na2jpn/ESP32C3_APRS-igate/APRS_igate_esp32c3.png

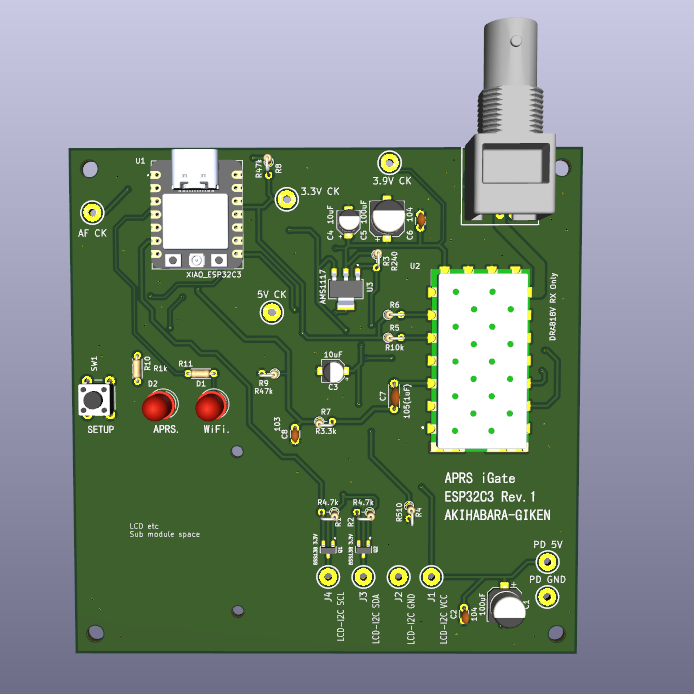
APRS_igate_esp32c3.png
