na2jpn/ESP32C3_APRS-igate/ESP32C3/APRS_iGate_C3_Rev1_2/README_JA.md

# APRS iGate ESP32C3 v1.2

XIAO ESP32C3 + DRA818V / 初期値144.660MHz / 1200bps Bell 202 AFSK受信専用。
秋葉原技研 / PS Ham-ware。2026-11-02。

## v1.2：8周波数プリセット・日英管理画面

管理画面の「受信周波数」で選択し、「保存して再起動」で保存します。
再起動後にDRA818V・Web・LCD・起動ログへ反映し、DRA初期化の再試行も保存値を使用します。

| MHz | 表示 / Region |
| --- | --- |
| 144.640 | — |
| 144.660 | JA・初期値 / default |
| 144.390 | US |
| 144.800 | EU |
| 145.175 | AU |
| 144.575 | NZ |
| 144.930 | AR |
| 145.570 | BR |

- 全周波数で1200bps AFSK。地域ラベルは代表例。日本の144.640MHzは一般に9600bps用ですが、本機に9600bps復調はありません。
- NVSの `rx_freq` に指定値を保存。未設定・不正な保存値は144.660MHz。v1.1の有効な保存値は維持します。
- Webから不正値は400で拒否。古い画面等から周波数項目を送らず保存した場合は選択を保持します。
- Wi-Fi・APRS-IS・自局ビーコン・OTAパスワードは引き継ぎます。RF/AFゲイン、DSP、ADC取得、PTT配線は変更しません。
- `/status` の `rf_mhz` と `afsk_baud` でも確認できます。

### 言語

各ページ上部の「日本語 / English」で切り替えます。設定・保存後/再起動待ち、音声モニター、受信記録、
ログ、OTAの案内・進捗・再試行メッセージを翻訳します。英語は `?lang=en`、日本語は `?lang=ja`。
言語指定なし・不明な指定は日本語です。通常の画面リンク・フォーム・60秒後の戻り先は選択言語を保持します。
言語は表示URLの指定で、NVSへの保存や再起動は不要です。英語を直接開く場合は `http://本機IP/?lang=en`。
未保存の入力は言語切り替えで失われます。OTA実行中は言語切り替えを抑止します。

ユーザーが入力したSSID・コメント・パケット本文は翻訳しません。生ログ、CSV列名、JSON/APIキー、
技術的な状態コードは従来の形式を保持します。時刻のJST表示は言語によって変更しません。

### 更新

初回USB：このフォルダーの `APRS_iGate_C3_Rev1_2.ino` を開き、全ヘッダー・生成済みUIを同じフォルダーに保持します。
既存v0.9以降のWeb OTA：`firmware/APRS_iGate_C3_v1.2_OTA.bin` を指定します。
更新後はRev1.2・RF・1200bps・APRS-IS VERIFIED・Samples増加・日英切り替えを確認してください。
詳細は同梱の初期設定PDFと[英語版概要](README_EN.md)、検証範囲は[TEST_NOTES.md](TEST_NOTES.md)。

以下は従来機能と修正経緯です。現在の周波数・言語設定は上記v1.2を優先してください。

## v1.0での修正経緯

旧版の144.640MHz / 1200bpsという組み合わせを、国内の一般的な1200bps運用に合わせて
144.660MHzへ修正しました。v1.0では固定でしたが、v1.1では上記の選択式になっています。
UART制御の9600bpsは無線側の通信速度とは別で、9600bps無線復調はありません。
PTTはハードウェアで受信状態に固定し、送信機能は追加していません。

### 実機で確認済みの範囲

2026-11-02、v0.12と試験用1200bps WAVを使い、ステータス3送信の正常復調、
さらに位置パケット1送信の正常復調・APRS-IS転送とaprs.fi位置表示をユーザーが確認しました。
表示経路はqAO,JH1HST-10。送受信周波数を合わせた試験であり、144.660MHzに変更した
v1.0の実機試験や、通常局の弱信号受信率・長時間安定性の確認を代替するものではありません。

## v0.12：音量計と本体での5秒ピーク保持

管理画面の「音声入力モニター / 波形・レベル」、または `http://本機IP/audio` を開きます。
認証は従来どおりadmin＋OTAパスワード（設定済みの場合）です。

- 緑バー：直近5個の40ms区間、約200msのAC RMS。測定平均からDC成分を除きます。
- 赤線：本体で連続集計した直近約5秒の最大40ms AC RMS。
  ブラウザーが取得しなかった区間も対象です。取得や別ブラウザーの閲覧で消費しません。
  高い値から約5秒経過すると、その時点で残っている区間の最大値まで下がります。
- 表示更新は約1秒間隔で、通信状況によって遅れます。
  集計自体は閲覧中のADCデータ全区間に対して行い、短い音をピークに残します。
  40ms未満の音は区間平均になるため、瞬間的なサンプル最大振幅そのものではありません。
- dBFSの基準は2048 ADCコード。%はその基準への線形比で、電波のS値・校正音圧ではありません。
- 波形は従来どおり最新40msの抜粋（264組の最小・最大）。音量計の200msとは別の測定窓です。
  波形40ms RMS、波形ピーク、ADC平均、Min/Max、端付近の数も別に表示します。
- 波形の固定倍率×1/×4/×16・自動倍率×1〜×32を継承します。
  倍率変更は波形だけに適用し、音量計の値を拡大しません。
- 一時停止は表示と値を保持します。要求停止から約3秒で本体のモニター計算が休止し、
  再開後は新しい履歴を作ります。APRS受信自体は表示停止で止まりません。
- 別タブで非表示、ページを閉じる、通信断による要求停止でも約3秒で休止。
  再試行待ちが3秒を超える場合も履歴はリセットされます。無人の常時記録ではありません。
- ADC読み取り失敗、データ欠落、復旧やOTAでは履歴を破棄します。
  無効な測定を音量ゼロとして表示せず、通信断でも古い値を消します。
- モニター固定RAMは3232B（v0.11から1048B増）。HTTP応答の一時ヒープは別です。
  追加のADC起動や新規タスクはありません。

### AMP追加を判断するための確認

FMでは無信号時の雑音が大きく、PTTを押すと音量計が下がる場合があります。
最初にPTTを押し無音で5秒程度待ち、待機雑音のピークが消えてから声や試験音を入れると、
入力された音のピークを比較しやすくなります。

同じ送信内容でデコードできた条件／できない条件を比較してください。
音量計・赤線・波形の振幅、上下限への張り付き、1200/2200Hz検出値、DMA欠落を併せて確認します。
音声経路が通ることだけでは、増幅不要・増幅必須のどちらも確定しません。
実電圧校正、RF感度、通常局のAPRS受信率、実機の追加CPU負荷は未検証です。
2026-11-02のv0.12実機試験では、1200bps試験WAVのRF受信・正常復調・APRS-IS転送・aprs.fi位置表示まで確認しました。

v0.11からの変更は音量計の集計・表示です。RFゲイン、DRA音量、復調しきい値、
ADC復旧処理、位置ビーコン、OTA、NTP、LCD/LEDは継承します。
Web OTAでは `firmware/APRS_iGate_C3_v1.1_OTA.bin` を指定してください。
更新後はRev1.1と接続状態を確認します。

## v0.10での変更と確認方法

v0.9実機ログで、Samplesが固定されたままTimeoutだけが増える状態を確認しました。
再起動後は実データが戻っています。停止を起こした根本原因は未確定です。
本版は受信停止の検知と復旧・記録を追加するもので、RF復調成功を保証するものではありません。

- 有効なADCデータが3秒来なければ、ADCタスク自身がstop→flush→startを実施します。
  3秒以上の間隔を空け最大3回。その後はFAULT表示を維持し、無限再試行や装置全体の自動再起動はしません。
  API成功後もRECOVERING表示を維持し、実データ受信後に復旧成功を記録します。
  有効データが継続する30秒間に読み取り失敗・欠落がなければ、試行回数の枠を戻します。
- 管理画面の「ADC取り込みを復旧」は同じ復旧処理を予約します。
  OTA中は409で拒否、ADC初期化失敗時は503で再起動が必要です。
  OTAパスワード設定時はadmin認証、未設定時も起動ごとのトークンを検証します。
- ADC表示：OK / STALE（データ鮮度1.5秒超・未受信など）/ RECOVERING /
  FAULT / PAUSED（OTA）/ INIT FAILED。初期化に成功しただけでOKにしません。
- モニターにTimeout、実取得サンプル数、最終取得からの時間、取得速度、復旧試行/成功数、
  意図的な破棄数を追加。本体ログは状態変化と10秒単位のoverflow/read error/timeout増分を記録します。
- 受信CSVの末尾に `adc_valid` 列を追加。1は実測、0は読み取り失敗です。
  `adc_valid=0` のRMS=0やMin/Max=2048は代用値であり、無音・実際のADC電圧を示しません。
- DMAプール8KB→16KB、ADCタスク優先度1→2。スタックは6144Bを維持し、
  最大4バッファ処理ごとに1tick休止します。欠落時は同期をリセットし最大32バッファを破棄します。
  DSPの毎サンプルの浮動小数点除算を同じ判定式の乗算比較へ変更しました。
  RFゲイン・AF音量・復調しきい値はv0.9から変更していません。
- 通常時のWi-Fi断は60秒継続してから設定APへ移行します。
  AP開始やWi-Fiスタック再初期化後はADC復旧を予約します。これが停止原因だと確定したわけではありません。
- v0.9のOTA再送・SHA256照合、位置ビーコン、NTP、LCD、LED、保存設定を継承します。

導入済みv0.9からは通常のWeb OTAで同梱のv0.10アプリbinを送信してください。
再接続後にRev0.10、APRS-IS VERIFIED、Samples/Captureの増加、Timeout・overflowの推移を確認します。
停止が再発した場合は、本体ログと受信CSVを再起動前に保存してください。
RAMログは電源断・再起動で消えます。長期間の無人保持はできません。

## 初回導入の注意

**自動再試行・途中再開が使えるのは、本体にv0.9を導入した後です。**
更新先binだけで動作中のv0.7/0.8のアップローダーは変えられません。
初回は通信が安定する環境、またはUSBで本版を書き込んでください。
旧版の送信が途中で切れた場合、電源を維持し、本体ログを保存して120秒の
セッション解除後に更新ページを開き直します。旧版の途中データは再開できません。

Web更新ファイル：`firmware/APRS_iGate_C3_v1.1_OTA.bin`（アプリ単体）。
ZIP/merged/bootloader/partitionsは送信しません。認証はadminとOTAパスワード。
設定は継承します。更新後はRev1.1・稼働時間・接続状態を確認してください。
v0.9でRTC記録形式を拡張したため、旧版から初回導入した直後のPREVIOUS OTAが
表示されない場合があります。v0.9以降同士の試験では記録の照合も使えます。

USB：`APRS_iGate_C3_Rev1_1.ino`と全ヘッダーを同じフォルダーへ。
Arduino IDE 2.3.10 / Core 3.3.12 / XIAO_ESP32C3 / Flash 4MB /
USB CDC On Boot Enabled / Default 4MB with spiffs (1.2MB APP/1.5MB SPIFFS)。
通常は全フラッシュ消去を無効にします。

## v0.9以降でのWeb更新

1. 管理画面のOTAリンクを開き直し、アプリ単体binを選択。
2. 「更新開始・再開」でSHA-256を計算し、1KBずつ送信します。
3. 通信断時は1/2/4/8/15秒（上限15秒）の間隔で受信位置を照合し、未受信分から継続。
4. 全量受信・SHA-256照合・イメージ検証後、2秒後に再起動。
5. 約30秒後から再接続を確認。版番号・稼働時間・本体ログ・VERIFIEDを確認。

- 1リクエストは30秒で打ち切り。操作ごとの復帰待ちは進捗なしで最大約8分。
- 更新全体に5分/8分の制限はありません。受信確認が続く限り継続します。
- 本体は最後の新規データ受信から10分で解除。状態照会や同一ブロック再送だけでは延長しません。
- 更新中もWi-Fi自動再接続と15秒間隔の再接続要求を行います。
  通常経路のAPRS再接続・AP移行・Wi-FiモードOFF/ON・長時間障害の強制再起動はOTA中に行いません。
- 受信・転送は更新中休止します。完全な無通信が続く場合は最長10分休止します。
- 中止ボタンも本体の応答を確認してから中止と表示します。届かない場合はタイムアウトで解除。
- 検証確定後の中止はできません。検証結果の照合中は結果確認を優先します。

### ページを閉じた・開き直した場合

本体の電源とセッションが維持されていれば、**同じブラウザー・同じURL（同じorigin）で
同じbinを選び、「更新開始・再開」**を押すと続行できます。
ファイル名ではなく全体SHA-256、サイズ、起動トークン、クライアントキー、セッションIDを照合します。
ブラウザーにはキー等のメタデータだけを保存し、ファイル本体・認証パスワードは保存しません。
localStorageが禁止されている場合、同じページ内の復帰はできますが、再読込後のキー保持はできません。
別ブラウザー・別URL・別ファイルへの自動引き継ぎはしません。10分経過で解除された後は最初から送ります。

### 応答が失われた場合の保険

- 開始要求は同じキー・SHA・サイズなら同じセッションを返し、Flashを再初期化しません。
- 書き込み済み位置を確認してから次へ進みます。
- 直前と同じオフセット・長さ・SHA-256のブロック再送はACKだけ返し、二重書き込みしません。
- 受信全体のSHA-256も本体で計算し、申告されたファイルのSHAと一致しなければ検証・起動切替をしません。
- 本体の起動トークンが変わった場合、送信途中のセッションは再開しません。
- 検証応答だけ失われて既に再起動した場合、対応ファームのRTC記録に同じSHA・キー・サイズの
  検証成功が残っていれば照合できます。対象ファームが新形式に非対応、電源断、RTC消失なら成功とは断定しません。

本体のIPが変わった場合、ブラウザーが別アドレスへ自動追従する機能はありません。
給電・Wi-Fi環境・ブラウザーのスリープ等、通信断そのものを防ぐ保証ではありません。
新アプリが起動不能になったときの自動ロールバックは未実装で、USB復旧が必要です。
SHA-256はファイル同一性と整合性の確認であり、署名による配布元認証ではありません。

## v0.8から継承

受信変化の診断記録、NTP/JST、約1dB分の弱入力しきい値調整をそのまま継承しています。
今回、RF・復調感度の追加変更はありません。

## まず診断記録を取る

1. 管理画面の **受信変化の記録 / RX diagnostics**（`/rxdiag`）を開く。
2. 必要なら「記録消去・再開」。約1秒、普段の音声レベルを学習させる。
3. 既知のAPRSパケットを送信する。
4. 送信後、速やかに「記録停止」→「CSVダウンロード」。録画は不要。
5. 自動記録が出ない場合は「記録再開」→「手動記録」を押してすぐ送信する。

音声のRMS上下変化、トーン合計・比率変化、ADC端付近、CRC・正常フレーム・
フレーム異常・DMA overflow・読み取り異常のカウンター変化をADCタスクで監視します。
雑音も記録対象です。記録があること自体はAPRS受信成功を意味しません。

- 約20ms（528サンプル）ごと。直前最大8行（160ms）＋開始点以後、合計最大48行（約960ms）。
- 最大4イベント。古いイベントから上書き。再起動・電源断で消えるRAM記録。
- 通常時、イベント終了後500msの再トリガー待機あり。正常フレーム・手動開始は待機を迂回。
- 1イベントの全期間を必ず収録する録音機能ではありません。raw音声は保存しません。
- RMSは復調器の平滑電力の区間平均から算出。1200/2200Hz値は各20ms区間末尾の検出値。
- ADC Min/Maxは区間全体。カウンターは累計と行間差分。最初の行の差分は0。
- ADC読み取り失敗の行はサンプル数不変、Min/Max=2048の便宜値。波形として解釈しません。
- イベントのreasonは期間中の理由のビット合計。trigger=1は開始行。complete=0は途中の記録。
- OTA中は記録を休止し、CSV取得・記録操作を拒否。完了後に確認してください。
- 雑音の変化が続くと4件が短時間で入れ替わるため、試験後は速やかに記録停止して保存。
- 本体イベントログ（4KB、`/logs`）とは別枠。どちらもOTAパスワード設定時はadmin認証。

初期しきい値：RMSは基準比30%かつ絶対差0.012以上、トーン合計は35%かつ0.006以上、
トーン比は0.45以上（合計0.008超）。比較は厳密には「超えた場合」。
ADC端付近は0〜16または4079〜4095。
平常値は約1秒の初期学習後、イベント外で追従します。
これは初期試験値です。取り逃し・雑音反応を実機CSVで評価します。

## NTP日時

Wi-Fi接続後、NICT / Cloudflare / pool.ntp.orgへ非同期で時刻合わせします。
受信開始を時刻同期待ちで止めません。JST表示です。

- 同期前はUNSYNCと起動からの経過msのみ。
- 同期後はJST日時（ミリ秒表示）と64bitの経過msを両方保存。
- 同期前の記録を後から同期済み日時へ書き換えません。
- 時計補正が起きても既存の記録日時は維持。順序・間隔の確認は経過msを使います。
- 管理画面のClockには最終同期からの経過秒も表示。通信断後は同期時点からの推定時計です。
- 記録日時はADCデータを処理した時点です。DMAバッファ遅延を含み、RF到来時刻の精密測定ではありません。
- ミリ秒表示は時刻精度を保証する意味ではありません。NTP実通信は実機確認が必要です。

## 小幅な復調しきい値変更

`config.h`の2定数のみ調整しました（RFゲイン、DRA音量・フィルター、ADC設定は変更なし）。

| 判定 | v0.7 | v0.8 |
| --- | ---: | ---: |
| AFSK_MIN_MEAN_SQUARE | 1.0e-5 | 8.0e-6 |
| AFSK_MIN_TONE_POWER | 2.0e-6 | 1.6e-6 |

電力しきい値20%低下、振幅しきい値約10.6%低下（約0.97dB）。
トーン判定のヒステリシス・ビット同期・HDLC/FCS/AX.25/APRS転送は維持します。
偽のCRC試行が増える可能性はありますが、CRC検証は緩めません。
**前回のRMS約0.13は旧しきい値を十分超えており、この調整だけで解決するとは主張しません。**
戻す場合は2定数をv0.7値へ戻してコンパイルするか、保管したv0.7アプリbinをOTAします。

## 継承機能・資料

位置ビーコンは有効時に認証後初回と以後30分。Gridは保存のみ。Commentは40バイト以内。
LCDは15分ごとに3画面×4秒×2周（約24秒）。短押し60秒。
正常LEDは30秒周期：0〜10秒Wi-Fi、10〜20秒APRS、20〜30秒両方消灯。
SETUPは離した時に判定：短押しLCD、5〜15秒未満AP、15秒以上全設定消去。
AP：APRS-iGate-XXXX / aprssetup / http://192.168.4.1/。
通常：http://aprs-igate.local/ または本機IP。設定保存後は60秒でトップに遷移します。

最新版の初期設定ガイドはZIP直下の `Initial_Setup_Guide_PDF/APRS_iGate_C3_v1_1_Initial_Setup_Guide_JA.pdf` を参照してください。
旧版PDFの144.640MHz表記は本版には適用しません。
v1.1の設定・機能と更新手順は本READMEを優先してください。旧版からの導入については本README冒頭の注意を参照してください。
検証詳細はTEST_NOTES.md。通常局の受信率・長時間安定性・追加診断のCPU負荷・NTP同期は継続確認事項です。
