na2jpn/ESP32C3_APRS-igate/diagram.pdf

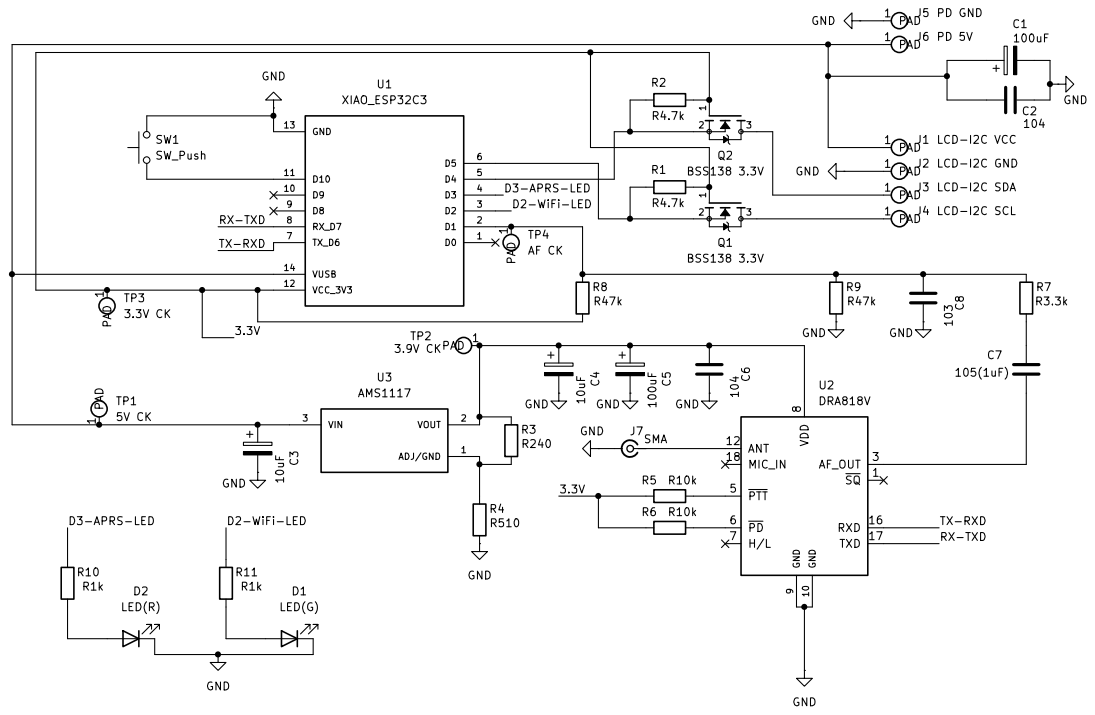
[picture p2: page 1]
