na2jpn/ESP32C3_APRS-igate/ESP32C3/APRS_iGate_C3_Rev1_2/settings.h

#pragma once

#include <Arduino.h>
#include <Preferences.h>
#include "config.h"

struct AppConfig {
  String rxFrequency = DEFAULT_DRA_RX_FREQ;
  String wifiSsid;
  String wifiPass;
  String callsign;
  String aprsPasscode;
  String aprsServer = DEFAULT_APRS_SERVER;
  uint16_t aprsPort = DEFAULT_APRS_PORT;
  String grid;
  bool beaconEnabled = false;
  String latitude;
  String longitude;
  String otaPassword;
  String comment = "RX-only APRS iGate";
};

class SettingsStore {
public:
  bool load(AppConfig &cfg) {
    Preferences p;
    if (!p.begin("igate", true)) return false;
    cfg.rxFrequency  = p.getString("rx_freq", DEFAULT_DRA_RX_FREQ);
    cfg.wifiSsid     = p.getString("ssid", "");
    cfg.wifiPass     = p.getString("wpass", "");
    cfg.callsign     = p.getString("call", "");
    cfg.aprsPasscode = p.getString("apass", "");
    cfg.aprsServer   = p.getString("server", DEFAULT_APRS_SERVER);
    cfg.aprsPort     = p.getUShort("port", DEFAULT_APRS_PORT);
    cfg.grid         = p.getString("grid", "");
    cfg.comment      = p.getString("comment", "RX-only APRS iGate");
    cfg.beaconEnabled = p.getBool("beacon", false);
    cfg.latitude = p.getString("lat", "");
    cfg.longitude = p.getString("lon", "");
    cfg.otaPassword = p.getString("otapass", "");
    p.end();
    normalize(cfg);
    return true;
  }

  bool save(AppConfig cfg) {
    normalize(cfg);
    Preferences p;
    if (!p.begin("igate", false)) return false;
    p.putString("rx_freq", cfg.rxFrequency);
    p.putString("ssid", cfg.wifiSsid);
    p.putString("wpass", cfg.wifiPass);
    p.putString("call", cfg.callsign);
    p.putString("apass", cfg.aprsPasscode);
    p.putString("server", cfg.aprsServer);
    p.putUShort("port", cfg.aprsPort);
    p.putString("grid", cfg.grid);
    p.putBool("beacon", cfg.beaconEnabled);
    p.putString("lat", cfg.latitude);
    p.putString("lon", cfg.longitude);
    p.putString("otapass", cfg.otaPassword);
    p.putString("comment", cfg.comment);
    p.end();
    return true;
  }

  void clear() {
    Preferences p;
    if (p.begin("igate", false)) {
      p.clear();
      p.end();
    }
  }

  static bool validRxFrequency(const String &frequency) {
    for (const auto &channel : RF_CHANNELS) {
      if (frequency == channel.frequency) return true;
    }
    return false;
  }

  static String rxFrequencyLabel(const AppConfig &cfg) {
    return cfg.rxFrequency.substring(0, 7);
  }

  static bool validForStation(const AppConfig &cfg) {
    return cfg.wifiSsid.length() > 0 && validCallsign(cfg.callsign);
  }

  static bool validCallsign(String s) {
    s.trim();
    s.toUpperCase();
    if (s.length() < 3 || s.length() > 9) return false;
    int hyphen = s.indexOf('-');
    String base = hyphen >= 0 ? s.substring(0, hyphen) : s;
    String ssid = hyphen >= 0 ? s.substring(hyphen + 1) : "";
    if (base.length() < 3 || base.length() > 6) return false;
    for (size_t i = 0; i < base.length(); ++i) {
      if (!isAlphaNumeric(base[i])) return false;
    }
    if (hyphen >= 0) {
      if (ssid.length() < 1 || ssid.length() > 2) return false;
      for (size_t i = 0; i < ssid.length(); ++i) {
        if (!isAlphaNumeric(ssid[i])) return false;
      }
      if (ssid == "0") return false;
    }
    return true;
  }

  static void normalize(AppConfig &cfg) {
    cfg.rxFrequency.trim();
    if (!validRxFrequency(cfg.rxFrequency)) cfg.rxFrequency = DEFAULT_DRA_RX_FREQ;
    cfg.wifiSsid.trim();
    cfg.callsign.trim();
    cfg.callsign.toUpperCase();
    cfg.aprsPasscode.trim();
    cfg.aprsServer.trim();
    cfg.latitude.trim();
    cfg.longitude.trim();
    cfg.grid.trim();
    cfg.grid.toUpperCase();
    cfg.comment.trim();
    if (cfg.aprsServer.length() == 0) cfg.aprsServer = DEFAULT_APRS_SERVER;
    if (cfg.aprsPort == 0) cfg.aprsPort = DEFAULT_APRS_PORT;
    if (cfg.comment.length() > 40) cfg.comment = cfg.comment.substring(0, 40);
  }
};
