na2jpn/ESP32C3_APRS-igate/ESP32C3/APRS_iGate_C3_Rev1_2/ui_texts.h

#pragma once
#include <cstring>
struct UiText { const char *key; const char *marker; const char *ja; const char *en; };
static const UiText UI_TEXTS[] = {
  {"rf.title", "{{rf.title}}", "受信周波数", "Receive frequency"},
  {"rf.default", "{{rf.default}}", "初期値", "default"},
  {"rf.note", "{{rf.note}}", "全周波数で1200bps AFSKです。日本の一般的な1200bps運用は144.660MHz、144.640MHzは一般に9600bps用です。本機は9600bpsの復調には対応していません。地域表示は代表例です。変更は保存・再起動後に反映します。", "All presets use 1200bps AFSK. In Japan, 144.660MHz normally uses 1200bps and 144.640MHz normally uses 9600bps. This device does not decode 9600bps. Region labels are examples. Save and reboot to apply changes."},
  {"field.ssid", "{{field.ssid}}", "Wi-Fi SSID", "Wi-Fi SSID"},
  {"field.wpass", "{{field.wpass}}", "Wi-Fiパスワード", "Wi-Fi password"},
  {"field.call", "{{field.call}}", "iGateコールサイン・SSID", "iGate callsign-SSID"},
  {"field.apass", "{{field.apass}}", "APRS-ISパスコード", "APRS-IS passcode"},
  {"field.server", "{{field.server}}", "APRS-ISサーバー", "APRS-IS server"},
  {"field.port", "{{field.port}}", "ポート", "Port"},
  {"field.grid", "{{field.grid}}", "グリッド（保存のみ）", "Grid (stored only)"},
  {"field.comment", "{{field.comment}}", "コメント", "Comment"},
  {"field.lat", "{{field.lat}}", "緯度（十進度・南緯は負）", "Latitude (decimal degrees, south negative)"},
  {"field.lon", "{{field.lon}}", "経度（十進度・西経は負）", "Longitude (decimal degrees, west negative)"},
  {"field.otapass", "{{field.otapass}}", "OTAパスワード（8～63文字・空欄で保持）", "OTA password (8-63 characters; blank keeps current)"},
  {"main.ip", "{{main.ip}}", "IP:", "IP:"},
  {"main.uptime", "{{main.uptime}}", "稼働時間:", "Uptime:"},
  {"main.decoded", "{{main.decoded}}", "復調:", "Decoded:"},
  {"main.gated", "{{main.gated}}", "転送:", "Gated:"},
  {"main.dup", "{{main.dup}}", "重複:", "Duplicates:"},
  {"main.blocked", "{{main.blocked}}", "除外:", "Blocked:"},
  {"main.crc", "{{main.crc}}", "CRC不一致:", "CRC bad:"},
  {"main.rms", "{{main.rms}}", "AF RMS:", "AF RMS:"},
  {"main.last", "{{main.last}}", "最終受信:", "Last RX:"},
  {"main.clock", "{{main.clock}}", "時刻:", "Clock:"},
  {"main.beacons", "{{main.beacons}}", "自局ビーコンTCP送出:", "Position beacon TCP writes:"},
  {"field.keep", "{{field.keep}}", "空欄で保存済み値を保持", "Blank keeps current"},
  {"main.monitor", "{{main.monitor}}", "AFSK受信モニター（1秒更新）", "AFSK receive monitor (updates every second)"},
  {"main.loading", "{{main.loading}}", "モニター取得中...", "Loading monitor..."},
  {"main.hint", "{{main.hint}}", "ADC最小・最大は直近250msの生コードです。1200/2200Hz値は検出強度で、校正済みdBではありません。ピークは約5秒保持します。", "ADC Min/Max are raw codes over the last 250ms. Tone values are detector magnitudes, not calibrated dB. RMS peak is held for about 5 seconds."},
  {"field.beacon", "{{field.beacon}}", "自局位置をAPRS-ISへ送る（30分間隔）", "Send own position to APRS-IS (every 30 minutes)"},
  {"button.save", "{{button.save}}", "保存・再起動", "Save &amp; Reboot"},
  {"link.rx", "{{link.rx}}", "受信変化の記録", "RX diagnostics"},
  {"link.audio", "{{link.audio}}", "音声入力モニター / 波形・レベル", "Audio input monitor / waveform and level"},
  {"link.logs", "{{link.logs}}", "本体ログ", "Device log"},
  {"link.ota", "{{link.ota}}", "ファームウェア更新（OTA）", "Firmware update (OTA)"},
  {"main.admin", "{{main.admin}}", "ユーザー名: admin", "User: admin"},
  {"button.adc", "{{button.adc}}", "ADC取り込みを復旧", "Recover ADC capture"},
  {"main.maintenance", "{{main.maintenance}}", "保守操作", "Maintenance"},
  {"confirm.factory", "{{confirm.factory}}", "保存設定をすべて消去しますか？", "Erase all saved settings?"},
  {"button.reboot", "{{button.reboot}}", "再起動", "Reboot"},
  {"button.factory", "{{button.factory}}", "設定を初期化", "Factory reset"},
  {"main.buttonhint", "{{main.buttonhint}}", "SETUPボタン: 短押しでLCDを60秒点灯 / 15分ごとに24秒自動点灯 / 5秒で設定AP / 15秒で全設定消去。設定APパスワード:", "SETUP: short press lights LCD for 60s / automatic 24s every 15 minutes / 5s opens setup AP / 15s erases all settings. Setup AP password:"},
  {"reboot.title", "{{reboot.title}}", "再起動中です", "Rebooting"},
  {"reboot.wait", "{{reboot.wait}}", "60秒後にトップ画面へ自動で戻ります。", "Returning to the main page automatically in 60 seconds."},
  {"reboot.home", "{{reboot.home}}", "トップ画面を開く", "Open the main page"},
  {"reboot.ip", "{{reboot.ip}}", "本機のIPアドレスが変わった場合は、新しいアドレスで開いてください。", "If the device IP address changed, open its new address."},
  {"live.unavailable", "{{live.unavailable}}", "モニター取得失敗: ", "Monitor unavailable: "},
  {"live.decoded", "{{live.decoded}}", " | 復調: ", " | Decoded: "},
  {"live.samples", "{{live.samples}}", " | サンプル: ", " | Samples: "},
  {"live.errors", "{{live.errors}}", " | 読取エラー: ", " | Read errors: "},
  {"live.timeout", "{{live.timeout}}", " | タイムアウト: ", " | Timeouts: "},
  {"live.age", "{{live.age}}", " | データ経過: ", " | Data age: "},
  {"live.rate", "{{live.rate}}", " | 取得速度: ", " | Capture rate: "},
  {"live.recovery", "{{live.recovery}}", " | 復旧試行/成功: ", " | Recovery attempts/success: "},
  {"live.discarded", "{{live.discarded}}", " | 破棄: ", " | Discarded: "},
  {"live.stack", "{{live.stack}}", " | スタック空き: ", " | Stack free: "},
  {"live.block", "{{live.block}}", " | 最大処理区間: ", " | Max block: "},
  {"error.rf", "{{error.rf}}", "受信周波数を一覧から選択してください。", "Select a receive frequency from the preset list."},
  {"error.password", "{{error.password}}", "OTAパスワードは8～63文字で指定してください。", "OTA password must be 8-63 characters."},
  {"error.position", "{{error.position}}", "位置ビーコンには有効な緯度・経度が必要です。", "Valid latitude and longitude are required for the position beacon."},
  {"error.config", "{{error.config}}", "SSIDまたはコールサインが不正です。", "SSID or callsign is invalid."},
  {"error.save", "{{error.save}}", "設定を保存できませんでした。", "Failed to save settings."},
  {"saved", "{{saved}}", "設定を保存しました。再起動します。", "Settings saved. Rebooting..."},
  {"erased", "{{erased}}", "設定を消去しました。再起動します。", "Settings erased. Rebooting..."},
  {"restarting", "{{restarting}}", "再起動します。", "Rebooting..."},
  {"error.busy", "{{error.busy}}", "OTA更新中です。完了または中止を待ってください。", "OTA in progress. Finish or cancel it first."},
  {"adc.requested", "{{adc.requested}}", "ADC復旧を予約しました。管理画面でサンプル増加と本体ログを確認してください。", "ADC recovery requested. Check sample progress and device logs on the main page."},
  {"error.adc", "{{error.adc}}", "ADC未初期化です。本体を再起動してください。", "ADC is not initialized. Reboot required."},
  {"logs.title", "{{logs.title}}", "本体ログ", "Device log"},
  {"logs.hint", "{{logs.hint}}", "最大4KB / 古い行から上書き / NTP同期後はJST日時と経過時間、同期前はUNSYNC表示。RAMログは再起動・電源断で消えます。", "Up to 4KB; oldest lines are overwritten. After NTP sync, timestamps use JST and uptime; otherwise UNSYNC. RAM logs are lost on reboot or power loss."},
  {"logs.refresh", "{{logs.refresh}}", "更新", "Refresh"},
  {"logs.download", "{{logs.download}}", "ダウンロード", "Download"},
  {"logs.clear", "{{logs.clear}}", "ログ消去", "Clear log"},
  {"logs.back", "{{logs.back}}", "管理画面へ戻る", "Back to main page"},
  {"logs.loading", "{{logs.loading}}", "読み込み中...", "Loading..."},
  {"logs.failure", "{{logs.failure}}", "ログ取得失敗: ", "Log fetch failed: "},
  {"logs.confirm", "{{logs.confirm}}", "ログを消去しますか？", "Clear the log?"},
  {"logs.clearfail", "{{logs.clearfail}}", "消去失敗: ", "Clear failed: "},
  {"rx.title", "{{rx.title}}", "受信変化の記録", "RX diagnostics"},
  {"rx.hint", "{{rx.hint}}", "音声・トーン・ADC・復調カウンターの怪しい変化を記録します。APRS受信の確定判定ではありません。最大4件、古いイベントから上書き。再起動・電源断で消えます。", "Records changes in audio, tones, ADC and decoder counters. Events do not prove an APRS reception. Up to 4 events; oldest overwritten. Lost on reboot or power loss."},
  {"rx.window", "{{rx.window}}", "約20msごと / 直前最大8行＋変化後、合計最大48行（約0.96秒）。トーンは各区間末尾の値、RMSは平滑電力の区間平均です。通信処理の遅れに左右されずADCタスクで記録します。", "About 20ms per row; up to 8 pre-trigger rows and 48 rows total (about 0.96s). Tones are end-of-window detector values; RMS averages smoothed power. Captured in the ADC task independently of HTTP timing."},
  {"rx.holdhint", "{{rx.holdhint}}", "送信後は「記録停止」で保持してからダウンロードしてください。待機時の雑音でも反応するため、記録が流れる場合があります。「手動記録」は次の区間から記録を開始します。", "After transmitting, freeze the records before downloading. Idle noise may trigger and overwrite events. Manual capture starts at the next interval."},
  {"rx.freeze", "{{rx.freeze}}", "記録停止", "Freeze records"},
  {"rx.resume", "{{rx.resume}}", "記録再開", "Resume recording"},
  {"rx.manual", "{{rx.manual}}", "手動記録", "Manual capture"},
  {"rx.clear", "{{rx.clear}}", "記録消去・再開", "Clear and resume"},
  {"rx.refresh", "{{rx.refresh}}", "表示更新", "Refresh"},
  {"rx.csv", "{{rx.csv}}", "CSVダウンロード", "Download CSV"},
  {"rx.log", "{{rx.log}}", "本体ログ", "Device log"},
  {"rx.back", "{{rx.back}}", "管理画面へ戻る", "Back to main page"},
  {"rx.loading", "{{rx.loading}}", "読み込み中...", "Loading..."},
  {"rx.reason", "{{rx.reason}}", "reason（ビット合計）: 1=RMS上下変化、2=トーン合計変化、4=トーン比変化、8=ADC端付近、16=CRC増加、32=正常フレーム、64=フレーム/DMA/読取異常、128=手動。trigger=1の行が開始点。adc_valid=0は有効なADCデータがない行です。差分カウンターは前の記録区間からの増分です。", "reason bit mask: 1=RMS change, 2=tone sum, 4=tone balance, 8=ADC edge, 16=CRC increase, 32=valid frame, 64=frame/DMA/read fault, 128=manual. trigger=1 marks the trigger row. adc_valid=0 means no valid ADC measurement. Delta counters are changes since the preceding interval."},
  {"rx.fetchfail", "{{rx.fetchfail}}", "取得失敗: ", "Fetch failed: "},
  {"rx.confirm", "{{rx.confirm}}", "診断記録を消去して再開しますか？", "Clear diagnostic records and resume?"},
  {"rx.opfail", "{{rx.opfail}}", "操作失敗: ", "Operation failed: "},
  {"scope.title", "{{scope.title}}", "音声入力モニター", "Audio input monitor"},
  {"scope.main", "{{scope.main}}", "管理画面", "Main page"},
  {"scope.rx", "{{scope.rx}}", "受信変化の記録", "RX diagnostics"},
  {"scope.logs", "{{scope.logs}}", "本体ログ", "Device log"},
  {"scope.intro", "{{scope.intro}}", "同じ周波数のFMで「あー → 無音 → あー」と数秒ずつ区切り、声に同期する変化を確認します。<b>電波のSメーターではなく、ESP32のADCに届いた音声の強さです。</b> FMは無信号時の雑音のほうが大きく、受信するとレベルが下がる場合もあります。", "Transmit voice, silence, then voice on the same FM frequency and watch for matching changes. <b>This is audio reaching the ESP32 ADC, not RF signal strength.</b> Idle FM noise may be louder than received audio."},
  {"scope.freeze", "{{scope.freeze}}", "一時停止・保持", "Pause and hold"},
  {"scope.gain", "{{scope.gain}}", "表示倍率", "Display gain"},
  {"scope.fixed", "{{scope.fixed}}", "固定", "Fixed"},
  {"scope.auto", "{{scope.auto}}", "自動拡大（DC除去）", "Auto scale (DC removed)"},
  {"scope.waiting", "{{scope.waiting}}", "取得待ち...", "Waiting for capture..."},
  {"scope.meterlabel", "{{scope.meterlabel}}", "音声入力 AC RMS dBFS", "Audio input AC RMS dBFS"},
  {"scope.meterhint", "{{scope.meterhint}}", "緑：直近200msのAC RMS ／ 赤線：本体で連続集計した直近約5秒の最大40ms AC RMS。2048 ADCコードを0 dBFSの基準とします。停止中は保持します。", "Green: latest 200ms AC RMS. Red: maximum 40ms AC RMS over about 5 seconds, accumulated on the device. 2048 ADC codes is the 0 dBFS reference. Pausing holds the display."},
  {"scope.await", "{{scope.await}}", "有効な測定を待っています。", "Waiting for valid measurements."},
  {"scope.canvas", "{{scope.canvas}}", "ADC入力波形", "ADC input waveform"},
  {"scope.range", "{{scope.range}}", "表示範囲：ADC 0〜4095 ／ ×1 ／ 中心2048", "Range: ADC 0-4095 / x1 / center 2048"},
  {"scope.wavehint", "{{scope.wavehint}}", "1枚約40ms、4サンプルごとの最小・最大を縦線表示。横軸は0〜40ms、縦軸はADCコードです。自動拡大では倍率・中心を明示します。入力端付近は赤色で警告します。ADCコードから電圧への校正は行っていません。", "Each frame covers about 40ms. Vertical lines show min/max for each group of four samples. X: milliseconds; Y: ADC codes. Auto scale shows gain and center. Near-edge input is red. ADC codes are not voltage-calibrated."},
  {"scope.bottom", "{{scope.bottom}}", "約1秒間隔で表示を更新します。音量と赤いピーク線は、閲覧中は本体で全40ms区間を連続集計します。波形は最新40msの抜粋で、連続録音ではありません。表示中のみ波形計算を行い、非表示・停止後は約3秒で休止。通信が遅い場合は重ねて要求せず再試行します。ブラウザーの一時停止はこの画面の表示だけを保持し、APRS受信を止めません。", "Refreshes about once per second. While viewed, the device accumulates every 40ms window for the level and peak. The waveform is only the latest 40ms, not continuous audio recording. Scope work pauses about 3s after viewing stops. Slow requests are retried without overlap. Pausing this display does not stop APRS reception."},
  {"scopejs.0", "{{scopejs.0}}", "表示倍率 ×", "Display gain x"},
  {"scopejs.1", "{{scopejs.1}}", "（自動・DC除去）", " (auto, DC removed)"},
  {"scopejs.2", "{{scopejs.2}}", "（固定）", " (fixed)"},
  {"scopejs.3", "{{scopejs.3}}", " ／ 中心ADC ", " / ADC center "},
  {"scopejs.4", "{{scopejs.4}}", " ／ 1枚 ", " / frame "},
  {"scopejs.5", "{{scopejs.5}}", "音量（200ms AC RMS） ", "Level (200ms AC RMS) "},
  {"scopejs.6", "{{scopejs.6}}", "%) ／ 5秒ピーク ", "%) / 5s peak "},
  {"scopejs.7", "{{scopejs.7}}", " ／ 波形40ms RMS ", " / waveform 40ms RMS "},
  {"scopejs.8", "{{scopejs.8}}", " ／ 波形ピーク ", " / waveform peak "},
  {"scopejs.9", "{{scopejs.9}}", " ／ ADC平均 ", " / ADC mean "},
  {"scopejs.10", "{{scopejs.10}}", " ／ Min/Max ", " / Min/Max "},
  {"scopejs.11", "{{scopejs.11}}", " ／ 端付近 ", " / near edge "},
  {"scopejs.12", "{{scopejs.12}}", "有効な測定なし。音量ゼロを意味しません。", "No valid measurement. This does not mean zero audio."},
  {"scopejs.13", "{{scopejs.13}}", "OTA中・音声モニター休止", "OTA active; audio monitor paused"},
  {"scopejs.14", "{{scopejs.14}}", "測定待ち / ", "Waiting for measurement / "},
  {"scopejs.15", "{{scopejs.15}}", " ／ 古い波形は表示しません。", " / stale waveform hidden."},
  {"scopejs.16", "{{scopejs.16}}", "取得中 ／ 本体の記録時点 ", "Capturing / device state "},
  {"scopejs.17", "{{scopejs.17}}", " ／ 取得時の波形経過 ", " / waveform age at fetch "},
  {"scopejs.18", "{{scopejs.18}}", " ms ／ 通信所要 ", " ms / request time "},
  {"scopejs.19", "{{scopejs.19}}", " ms ／ 取得番号 ", " ms / sequence "},
  {"scopejs.20", "{{scopejs.20}}", " ／ ADC端付近あり（入力レベル・バイアスを確認）", " / ADC near edge (check level and bias)"},
  {"scopejs.21", "{{scopejs.21}}", "通信待ち：", "Waiting for connection: "},
  {"scopejs.22", "{{scopejs.22}}", " ／ 再試行します。", " / retrying."},
  {"scopejs.23", "{{scopejs.23}}", "表示を再開", "Resume display"},
  {"scopejs.24", "{{scopejs.24}}", "一時停止・保持", "Pause and hold"},
  {"scopejs.25", "{{scopejs.25}}", "一時停止・保持中（受信は継続）", "Paused and held (reception continues)"},
  {"scopejs.26", "{{scopejs.26}}", "表示を再開・測定待ち...", "Resuming; waiting for measurement..."},
  {"scopejs.27", "{{scopejs.27}}", "取得待ち...", "Waiting for capture..."},
  {"otajs.0", "{{otajs.0}}", "対応するOTA状態を取得できません。本体ログと版番号を確認してください。", "Compatible OTA status unavailable. Check the device log and firmware version."},
  {"otajs.1", "{{otajs.1}}", "本体が再起動し、更新セッションが失われました。途中からの送信は行いません。", "Device rebooted and the update session was lost. The partial transfer will not resume."},
  {"otajs.2", "{{otajs.2}}", "更新セッションまたはファイルが一致しません。別の更新を上書きしません。", "Update session or file mismatch. Another update will not be overwritten."},
  {"otajs.3", "{{otajs.3}}", "セッションIDが変わりました。再開を停止します。", "Session ID changed. Resume stopped."},
  {"otajs.4", "{{otajs.4}}", "受信位置が不正です。", "Invalid receive offset."},
  {"otajs.5", "{{otajs.5}}", "本体受信確認: ", "Device confirmed: "},
  {"otajs.6", "{{otajs.6}}", " バイト (", " bytes ("},
  {"otajs.7", "{{otajs.7}}", "%)\\n再試行: ", "%)\\nRetries: "},
  {"otajs.8", "{{otajs.8}}", " 回", " times"},
  {"otajs.9", "{{otajs.9}}", "約8分の再接続待ちで進捗を確認できませんでした。同じブラウザーで同じbinを選び直すと、セッションが残っていれば再開できます。本体は最終データ受信から10分で解除します。", "No progress confirmed after about 8 minutes of reconnect attempts. Select the same bin in the same browser to resume if the session remains. The device releases it 10 minutes after the last new data."},
  {"otajs.10", "{{otajs.10}}", " / 再接続待ち ", " / reconnect in "},
  {"otajs.11", "{{otajs.11}}", "秒 / 再試行 ", "s / retries "},
  {"otajs.12", "{{otajs.12}}", "回\\n最終確認: ", "\\nLast confirmed: "},
  {"otajs.13", "{{otajs.13}}", " バイト。電源とこのページを維持してください。", " bytes. Keep power and this page active."},
  {"otajs.14", "{{otajs.14}}", "中止要求中。通信の復帰後、本体の中止確認を待ちます。", "Cancel requested. Waiting for the device to confirm after reconnecting."},
  {"otajs.15", "{{otajs.15}}", "本体が再起動したか、OTA形式が異なります。更新ページを開き直してください。", "Device rebooted or OTA protocol differs. Reopen the update page."},
  {"otajs.16", "{{otajs.16}}", "本体が更新を解除しました: ", "Device released the update: "},
  {"otajs.17", "{{otajs.17}}", "開始応答を照合しています", "Reconciling the start response"},
  {"otajs.18", "{{otajs.18}}", "送信中のセッションが終了しました: ", "Transfer session ended: "},
  {"otajs.19", "{{otajs.19}}", "状態不一致", "State mismatch"},
  {"otajs.20", "{{otajs.20}}", "予期しない受信位置です。二重送信を避けるため停止しました。", "Unexpected receive offset. Stopped to avoid duplicate writes."},
  {"otajs.21", "{{otajs.21}}", "ブロックの受信確認位置が一致しません。", "Confirmed block offset does not match."},
  {"otajs.22", "{{otajs.22}}", "受信済み位置を照合しています", "Reconciling received offset"},
  {"otajs.23", "{{otajs.23}}", "本体の検証が完了していません: ", "Device verification incomplete: "},
  {"otajs.24", "{{otajs.24}}", "セッション解除", "Session released"},
  {"otajs.25", "{{otajs.25}}", "全量受信を確認できません。", "Full image receipt not confirmed."},
  {"otajs.26", "{{otajs.26}}", "検証成功を確認できません。", "Successful verification not confirmed."},
  {"otajs.27", "{{otajs.27}}", "検証結果と再起動後の記録を照合しています", "Reconciling verification and reboot records"},
  {"otajs.28", "{{otajs.28}}", "送信開始前に中止しました。", "Cancelled before transfer started."},
  {"otajs.29", "{{otajs.29}}", "検証済みです。中止できません。再起動後の状態を確認してください。", "Already verified; cancellation is unavailable. Check the state after reboot."},
  {"otajs.30", "{{otajs.30}}", "更新セッションの終了を確認しました。通常処理へ戻ります。", "Update session ended. Returning to normal operation."},
  {"otajs.31", "{{otajs.31}}", "中止を確認できません。", "Cancellation not confirmed."},
  {"otajs.32", "{{otajs.32}}", "更新を中止しました。受信処理は再開されます。", "Update cancelled. Reception will resume."},
  {"otajs.33", "{{otajs.33}}", "中止確認待ち", "Waiting for cancel confirmation"},
  {"otajs.34", "{{otajs.34}}", "再接続しました。現在のファーム: ", "Reconnected. Current firmware: "},
  {"otajs.35", "{{otajs.35}}", " / 更新前: ", " / previous: "},
  {"otajs.36", "{{otajs.36}}", "。検証成功は確認済みです。本体ログ・稼働時間・接続状態を確認してください。", ". Verification succeeded. Check the device log, uptime and connections."},
  {"otajs.37", "{{otajs.37}}", "再接続確認: ", "Reconnect check: "},
  {"otajs.38", "{{otajs.38}}", "検証成功済み。再起動後の接続を待っています", "Verified. Waiting for the device to reconnect after reboot"},
  {"otajs.39", "{{otajs.39}}", "検証成功済みですが再接続を確認できません。本体のIPとログを確認してください。", "Verified, but reconnection could not be confirmed. Check the device IP and logs."},
  {"otajs.40", "{{otajs.40}}", ".bin を選択してください。", "Select a .bin file."},
  {"otajs.41", "{{otajs.41}}", "ファイルのSHA-256を計算しています...", "Computing file SHA-256..."},
  {"otajs.42", "{{otajs.42}}", "全データの受信・SHA-256照合・イメージ検証が完了しました。約30秒後に再接続を確認します。", "Full image received, SHA-256 matched and image verified. Checking reconnection in about 30 seconds."},
  {"otajs.43", "{{otajs.43}}", "中止を確認できません: ", "Cancellation not confirmed: "},
  {"otajs.44", "{{otajs.44}}", "\\n本体ログを確認してください。", "\\nCheck the device log."},
  {"otajs.45", "{{otajs.45}}", "更新の完了を確認できません: ", "Update completion not confirmed: "},
  {"otajs.46", "{{otajs.46}}", "\\n通信断だけでは成功とは判断しません。本体ログを確認してください。セッションが残っていれば同じbinで再開できます。", "\\nConnection loss alone does not prove success. Check the device log. Resume with the same bin if the session remains."},
  {"ota.title", "{{ota.title}}", "ファームウェア更新 v1.2", "Firmware update v1.2"},
  {"ota.intro", "{{ota.intro}}", "本機用のアプリ単体 .bin を選択してください。更新中は受信・転送を一時休止します。電源を維持し、ブラウザーのスリープを避けてください。", "Choose the application-only .bin for this device. Reception and forwarding pause during updates. Keep power connected and prevent browser sleep."},
  {"ota.hint", "{{ota.hint}}", "通信断は自動再試行（進捗がない状態で最大約8分）。本体は最終データ受信から10分で解除します。遅くても進捗があれば継続します。ページを開き直した場合は、同じブラウザーで同じbinを選択し「更新開始・再開」を押してください。保存領域を利用できないブラウザーではページ再読込後の再開はできません。", "Connection loss triggers retries, for up to about 8 minutes without progress. The device releases the session 10 minutes after the last new data. Slow transfers continue while progressing. To resume after reopening, select the same bin in the same browser and press Start or resume. Resume across reloads requires browser storage."},
  {"ota.start", "{{ota.start}}", "更新開始・再開", "Start or resume"},
  {"ota.cancel", "{{ota.cancel}}", "中止", "Cancel"},
  {"ota.wait", "{{ota.wait}}", "待機中 / 受信位置とファイルSHA-256を照合して続行します。", "Ready / resume checks the receive offset and file SHA-256."},
  {"ota.logs", "{{ota.logs}}", "本体ログ", "Device log"},
  {"ota.back", "{{ota.back}}", "管理画面へ戻る", "Back to main page"},
  {"lang", "{{lang}}", "ja", "en"},
  {"rx.frozen", "{{rx.frozen}}", "記録停止。保存した記録は保持されています。", "Recording frozen. Stored events are retained."},
  {"rx.accepted", "{{rx.accepted}}", "操作を受け付けました。", "Operation accepted."},
  {"error.ota.password", "{{error.ota.password}}", "先にOTAパスワードを設定してください。", "Set OTA password first."},
  {"error.ota.token", "{{error.ota.token}}", "トークンが無効です。更新ページを開き直してください。", "Invalid token; reopen update page."},
  {"error.ota.slot", "{{error.ota.slot}}", "OTA領域がありません。Default 4MB OTA構成でUSBから導入してください。", "No OTA slot. Install by USB with Default 4MB OTA partitions."},
};
static inline const char *uiText(const char *key, bool english) {
  for (const auto &t : UI_TEXTS) if (std::strcmp(t.key, key) == 0) return english ? t.en : t.ja;
  return key;
}
static inline String uiLocalize(String page, bool english) {
  for (const auto &t : UI_TEXTS) page.replace(t.marker, english ? t.en : t.ja);
  return page;
}
